AragogMathiMay/Aragog/RAPPORT DU PROJET ARAGOG #8.pdf

# RAPPORT DU PROJET ARAGOG #8

## S E M A I N E D U 06 / 03 / 19:

## INTRODUCTION:

Nous avons terminé notre projet!

POINTS POSITIFS | POINTS NÉGATIFS
- Mathilde a peaufiné les derniers détails car puisque nous avions emmené Aragog à la journée portes ouvertes et qu’elle a beaucoup fonctionné, certaines pattes étaient un peu lâches, donc il a fallu les resserrer. ● Elle a aussi rajouté une fonction au programme de contrôl du robot pour compléter tous les mouvements que nous voulions lui donner ● De mon côté j’ai travaillé sur le rapport final tout au long de cette séance, après avoir rédigé un plan avec nos idées clefs tout en s’appuyant sur les consignes imposées, j’ai entamé la rédaction. | ● ∅

## CE QUE JE RETIENS DE LA SÉANCE:

Il ne nous reste qu’à passer la soutenance sur ce projet et on pourra officiellement le déclarer comme aboutit. :)

## OBJECTIFS POUR LA FUTURE SÉANCE:

- La soutenance

## F I N D U R A P P O R T #8
